nik0793/estacion-nativa/imagenes/dispositivos/mt3608-step-up.webp

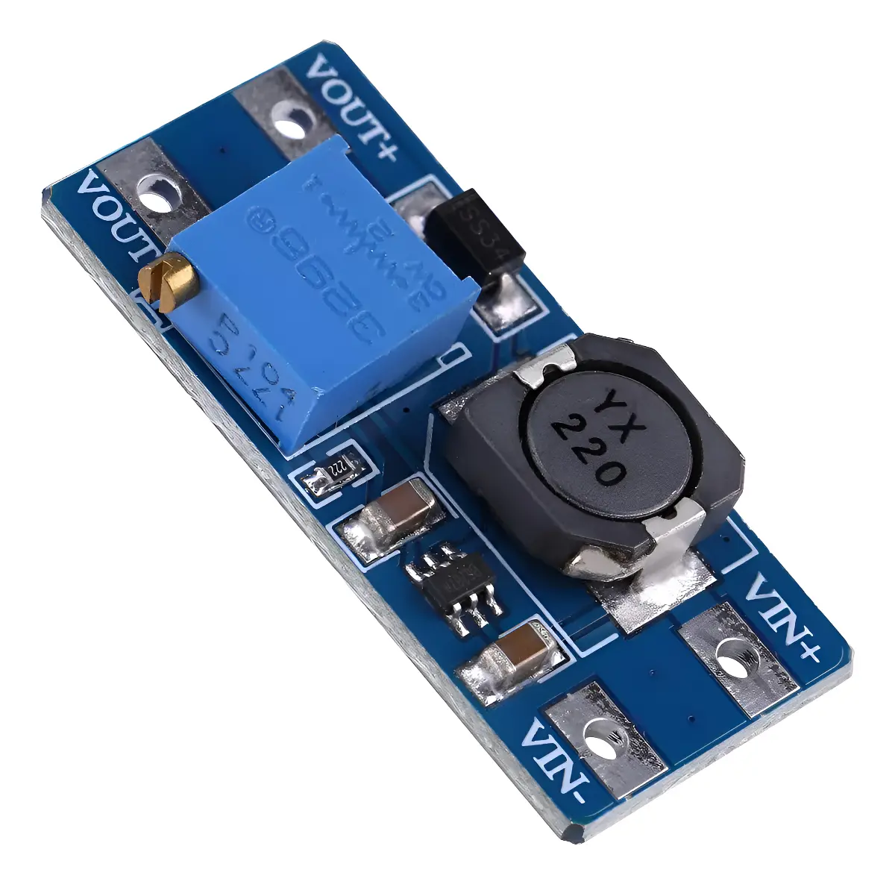
imagenes/dispositivos/mt3608-step-up.webp
