nik0793/estacion-nativa/imagenes/renders/05-maestra.png

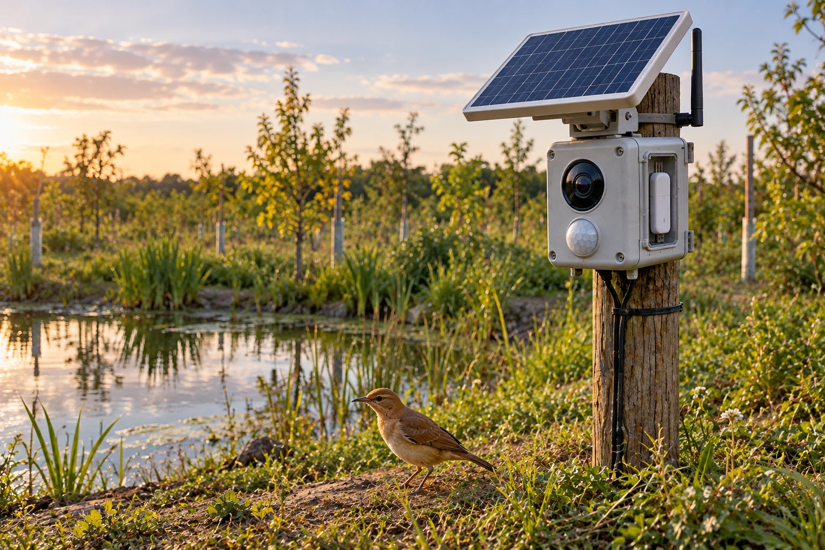
imagenes/renders/05-maestra.png
