nik0793/estacion-nativa/docs/informe-tecnico.html

Ecoestudio Solar · Proyecto de recuperación de aves nativas · Del Viso

# Estación Nativa Informe técnico para el taller · versión 1.0

Estación solar de agua y registro fotográfico de aves, con módem 4G compartido por sector. Lista de materiales con precios verificados, cálculo de energía, conexiones pin por pin, armado paso a paso, configuración del módem, especificación del firmware y del servidor.

Cómo usar este documento. Está escrito para ejecutarse en orden: primero la sección 7 (armado de una estación en la mesa) con la sección 6 (conexiones) al lado, después la 8 (módem), la 9 (firmware) y recién al final la 11 (campo). Cada paso termina en una verificación con el multímetro o con el monitor serie. Si una verificación falla, no seguir.

Preparado por Nicolás Gutiérrez · 11 de octubre de 2026 · Precios en pesos argentinos tomados de publicaciones de MercadoLibre el 11/10/2026 (ver links en la sección 3).

Carpeta del proyecto: D:\Documentos\estacion-aves · Repositorio público: github.com/nik0793/estacion-nativa · Fotos de los componentes en imagenes\dispositivos · Prompts para los renders en docs\prompts-imagenes.md

## 1. Qué vamos a construir

Un sector es un grupo de estaciones alrededor de un punto de interés (el estanque) a pocos metros entre sí. Todas comparten un solo módem 4G USB con WiFi y un solo chip. Cada estación es autónoma en energía: panel solar chico, dos pilas 18650 y un ESP32-CAM que duerme casi todo el tiempo.

- Estación base (la que se repite): ESP32-CAM + sensor PIR + panel + pilas. Saca dos fotos cuando un ave se posa, las guarda en su memoria flash y las sube en la próxima ventana de conexión.
- Estación maestra (una por sector): es una estación base que además enciende el módem 4G en ventanas horarias con una llave MOSFET y paneles y pilas extra.
- Estación comedero (una por sector): es una estación base que además mueve un servo dosificador de alimento en horarios programados y mide con una boya el nivel del tanque de agua.
- Agua: tanque de 20 litros por gravedad con válvula a flotante mecánica en el bebedero. No consume energía; el equipo solo avisa cuando el tanque está por vaciarse.

Figura 1. Arquitectura. Las estaciones no hablan entre sí: cada una se conecta al WiFi del módem en la ventana y habla con el servidor.

## 2. Decisiones de diseño (y por qué)

Decisión | Razón
El equipo duerme en deep sleep y el módem está apagado salvo en ventanas de 6 minutos por hora. | Un módem 4G encendido todo el día consume unas 10 veces más que todo el resto. Es lo único que permite usar paneles de 1,5 W y dos pilas.
Un módem por sector, compartido por WiFi. | Un solo chip y un solo equipo de 63.000 $ para 4 o más cámaras. Agregar una cámara cuesta solo la cámara.
Sin microSD: las fotos se guardan en la flash del ESP32 (LittleFS, 1,5 MB) hasta la ventana. | Libera 6 pines del ESP32-CAM (que es el cuello de botella), saca un componente que falla con humedad y ahorra energía. 1,5 MB guarda unas 30 fotos; sobra para una hora.
Agua por gravedad con flotante mecánico. | Cero energía, cero bombas, cero firmware. Es la parte que más usan las aves y la que menos puede fallar.
Una sola fuente de 5 V (módulo TP4056 + MT3608 integrados) alimenta al ESP32-CAM por su pin 5V. | Un módulo de 4.390 $ hace carga solar, protección de la pila y 5 V. Cuesta unos 6 mA extra en sueño; se acepta en v1 y se mejora en v2 (sección 13).
El PIR se alimenta directo de la pila (3,7 a 4,2 V), no de los 5 V. | El regulador del HC-SR501 funciona desde 3,6 V. Así el PIR sigue vivo con el ESP32 dormido y gasta 50 µA.
Identificación de especie en el servidor, no en el equipo. | BirdNET necesita una Raspberry Pi, que consume más en una hora que la estación en un día.
Los pájaros no se ven en vivo. Las órdenes (dar comida, sacar foto, cambiar horario) se ejecutan en la próxima ventana. | Consecuencia directa de dormir el módem. Hasta una hora de demora es aceptable para este uso.

## 3. Lista de materiales con precios verificados

Precios tomados el 11/10/2026 de las publicaciones indicadas. Los marcados (est.) son estimaciones de ferretería o insumos que ya tenés. Las fotos están en imagenes\dispositivos.

### 3.1 Estación base (se repite en cada punto)

Foto | Componente | Cant. | Unitario $ | Subtotal $ | Vendedor / publicación
 | ESP32-CAM con cámara OV2640 (AI-Thinker). Cerebro, WiFi y cámara en una placa de 27×40 mm. | 1 | 24.559 | 24.559 | Starware (Full) · MLA-784007609 (https://articulo.mercadolibre.com.ar/MLA-784007609-esp32-cam-camara-modulo-wifi-bt-arduino-ov2640-2mp-_JM)
 | Módulo J5019: cargador TP4056 + elevador MT3608, entrada USB-C y pads IN+/IN-, salida regulable 4,3 a 27 V, 1 A, con protección de la pila. | 1 | 4.390 | 4.390 | Informática San Isidro · MLA-1981186488 (https://articulo.mercadolibre.com.ar/MLA-1981186488-cargador-bateria-litio-tp4056-1a-con-fuente-boost-step-up-2a-_JM)
 | Panel solar 6 V 1,5 W epoxi, 112×91 mm, 250 mA. Van dos en paralelo. | 2 | 14.999 | 29.998 | Candy-Ho · MLA-637068205 (https://articulo.mercadolibre.com.ar/MLA-637068205-panel-solar-policristalino-mini-epoxy-6v-0-250ma-112x91-mm-_JM)
 | Pila 18650 3,7 V 3000 mAh. Van dos en paralelo. Hay celdas de 8.000 a 12.000 $ y recuperadas de notebook gratis; verificar capacidad real antes de usarlas. | 2 | 26.114 | 52.228 | Fullenergy · MLA-833373093 (https://articulo.mercadolibre.com.ar/MLA-833373093-bateria-recargable-de-litio-18650-37v-3000mah-_JM)
| Portapilas doble 18650 con cables. | 1 | 3.000 | 3.000 | (est.)
 | Sensor PIR HC-SR501. Despierta al ESP32 cuando algo se mueve frente al bebedero. | 1 | 3.229 | 3.229 | TodoMicro · MLA-878891033 (https://articulo.mercadolibre.com.ar/MLA-878891033-modulo-sensor-movimiento-pir-infrarrojo-hc-sr501-arduino-_JM)
| Dos resistencias de 100 kΩ, cable fino, conectores Dupont o JST, termocontraíble, un capacitor electrolítico de 470 µF 10 V. | 1 | 4.000 | 4.000 | (est.)
| Caja impresa en PETG o ASA, prensacable, tornillos, abrazaderas y poste de madera de 1 m. | 1 | 10.000 | 10.000 | (est.)
| Subtotal estación base | | | 131.404

### 3.2 Extras de la estación maestra (una por sector)

Foto | Componente | Cant. | Unitario $ | Subtotal $ | Vendedor / publicación
 | Módem 4G USB con WiFi, liberado. Bandas LTE B1/B2/B3/B4/B5/B7/B8/B17/B20/B28 (incluye B4 y B28, las de Argentina), hasta 10 equipos por WiFi, WPA2. Garantía del vendedor 1 mes, devolución ML 30 días. | 1 | 63.000 | 63.000 | Techno Space 044 (Full) · MLAU3374858134 (https://www.mercadolibre.com.ar/modem-4g-usb-wifi-liberado-inalambrico-lte/up/MLAU3374858134)
 | Elevador MT3608 2 A dedicado al módem, ajustado a 5,0 V. | 1 | 4.219 | 4.219 | Informática San Isidro · MLA-768204545 (https://articulo.mercadolibre.com.ar/MLA-768204545-fuente-convertidor-boost-elevador-dc-dc-step-up-2a-mt3608-_JM)
 | MOSFET AOD4184 (canal N, nivel lógico, TO-252). Llave que corta la alimentación del módem. Se suelda sobre un trozo de plaqueta perforada o adaptador. | 1 | 6.087 | 6.087 | ITT · MLA-640228615 (https://articulo.mercadolibre.com.ar/MLA-640228615-mosfet-n-aod4184a-40v-50a-to252-aod4184-_JM)
 | Dos paneles 6 V 1,5 W más (la maestra lleva cuatro). | 2 | 14.999 | 29.998 | Candy-Ho · MLA-637068205
 | Dos pilas 18650 más (la maestra lleva cuatro) y un portapilas doble extra. | 2 | 26.114 | 55.228 | Fullenergy · MLA-833373093 (+3.000 est. portapilas)
| Conector USB-A hembra para alimentar el módem, 100 Ω y 100 kΩ para el gate. | 1 | 1.500 | 1.500 | (est.)
| Subtotal extras maestra | | | 160.032

### 3.3 Extras de la estación comedero (una por sector)

Foto | Componente | Cant. | Unitario $ | Subtotal $ | Vendedor / publicación
 | Servo SG90 para la compuerta de la tolva de alimento. | 1 | 5.998 | 5.998 | Marstech · MLA79821906 (https://www.mercadolibre.com.ar/servo-motor-tower-pro-sg90-9g-compatible-arduino-rotacion/p/MLA79821906)
 | Segundo AOD4184 para cortar la alimentación del servo cuando no se usa. | 1 | 6.087 | 6.087 | ITT · MLA-640228615
 | Sensor de nivel a boya (interruptor flotante) para el tanque de agua. | 1 | 14.520 | 14.520 | ITT · MLA-830475459 (https://articulo.mercadolibre.com.ar/MLA-830475459-sensor-nivel-liquido-electrico-boya-flotante-itytarg-_JM)
| Bidón de 20 L, válvula flotante mecánica de 1/2" (tipo tanque de inodoro o bebedero de animales), manguera y bebedero de piedra o cemento. | 1 | 15.000 | 15.000 | (est., ferretería)
| Tolva impresa con compuerta para el servo. | 1 | 3.000 | 3.000 | (est., filamento)
| Subtotal extras comedero | | | 44.605

### 3.4 Comunes a todo el proyecto

Foto | Componente | Cant. | Unitario $ | Subtotal $ | Vendedor / publicación
 | Placa programadora ESP32-CAM-MB (CH340). Una sola para programar todas las estaciones. | 1 | 8.999 | 8.999 | HobbyTronica · MLA-1138363194 (https://articulo.mercadolibre.com.ar/MLA-1138363194-placa-base-programador-esp32-cam-ov2640-esp32-cam-mb-hobb-_JM)
| Chip prepago de la operadora con mejor señal en el predio + primer pack de 1 GB. | 1 | 5.000 | 5.000 | (est.) · costo mensual después: 3.000 a 5.000 $

## 4. Presupuesto del sector estanque (4 estaciones)

Ítem | Cant. | $
Estación base completa (incluye la de la maestra y la del comedero) | 4 | 525.616
Extras de la maestra (módem, llave, paneles y pilas extra) | 1 | 160.032
Extras del comedero (servo, boya, tanque, tolva) | 1 | 44.605
Programador y chip con primer mes | 1 | 13.999
Total del sector, todo nuevo | | 744.252
Costo mensual (datos del chip) | | 3.000 a 5.000

Dónde se puede bajar. Las pilas son el 29 % del total (8 celdas a 26.114 $). Con celdas recuperadas de packs de notebook, el sector baja a unos 535.000 $; con celdas nuevas de 10.000 $, a unos 615.000 $. La segunda partida grande son los 10 paneles de 1,5 W (150.000 $): para la maestra conviene cotizar un panel de 6 V 5 W o 6 W único, que suele salir menos que cuatro chicos.

Referencia: la alternativa con una placa integrada Waveshare ESP32-S3-SIM7670G cuesta 180.000 $ por estación más un chip por estación. Cuatro habrían salido 720.000 $ solo en placas.

### Para empezar: compra mínima de la etapa 1 (una estación en la mesa)

ESP32-CAM, programador, módulo J5019, dos paneles, dos pilas, portapilas, PIR y menudencias: unos 131.000 $ más el programador (9.000 $). Con eso se prueba todo el firmware usando el WiFi de tu casa como si fuera el módem. El módem se compra recién cuando la estación ya sube fotos.

## 5. Energía: por qué alcanza con paneles de 1,5 W

### 5.1 Consumo diario estimado

Carga | Cálculo | mAh/día
ESP32-CAM en deep sleep alimentado por el pin 5V (regulador AMS1117 + cámara) más pérdidas del elevador | 9 mA × 24 h | 216
PIR HC-SR501 desde la pila | 0,05 mA × 24 h | 1
Divisor de medición de batería (100 k + 100 k) | 0,02 mA × 24 h | 1
Eventos: despertar, encender cámara, 2 fotos, guardar | 40 eventos × 8 s × 250 mA | 22
Ventanas de subida: WiFi, NTP, subir ~10 fotos, bajar órdenes | 14 ventanas × 60 s × 200 mA | 47
Estación base | ≈ 1,1 Wh/día a 3,7 V | ≈ 290
Extra maestra: módem 4G encendido en las ventanas | 14 ventanas × 6 min × 1,2 W ≈ 1,7 Wh | ≈ 460
Estación maestra | ≈ 2,8 Wh/día | ≈ 750
Extra comedero: servo 2 veces por día, 5 s | despreciable | 1

### 5.2 Generación y autonomía

- Un panel epoxi de 1,5 W rinde al sol real cerca de 1 W. En Buenos Aires en invierno hay unas 2,5 horas equivalentes de sol pleno sobre un panel inclinado al norte. Con 85 % de rendimiento de carga: unos 2,1 Wh por panel por día en invierno, el doble en verano.
- Estación base: 2 paneles ≈ 4,2 Wh/día contra 1,1 Wh de consumo. Cubre cuatro días nublados seguidos sin tocar la reserva.
- Maestra: 4 paneles ≈ 8,5 Wh/día contra 2,8 Wh.
- Reserva: base 2 × 3000 mAh = 6000 mAh → 20 días sin sol. Maestra 4 × 3000 mAh → 16 días sin sol.

Verificación obligatoria en el paso 7.9: con el equipo dormido, el multímetro en serie con la pila tiene que marcar entre 7 y 11 mA en la estación base. Si marca más de 15 mA, algo quedó encendido (cámara sin apagar, LED de flash, módulo PIR mal alimentado) y hay que corregirlo antes de instalar.

Figura 2. Ciclo diario. Las estaciones despiertan a los 60 s de cada hora y buscan el WiFi del módem durante 2 minutos como máximo.

## 6. Conexiones pin por pin

### 6.1 Pines del ESP32-CAM que se usan

Pin ESP32-CAM | Función en la estación | Detalle
5V | Alimentación | Desde OUT+ del módulo J5019 ajustado a 5,0 V. Capacitor de 470 µF entre 5V y GND, lo más cerca posible de la placa.
GND | Masa común | Todas las masas unidas: J5019 OUT-, BAT-, PIR GND, divisor, MOSFET source.
GPIO13 | PIR OUT | Entrada de despertar (ext0, flanco alto). Es pin RTC, por eso funciona en deep sleep.
GPIO15 | Medición de batería | Punto medio del divisor 100 k / 100 k entre BAT+ y GND. Se lee por ADC2 antes de encender WiFi.
GPIO4 | Llave del módem (solo maestra) | Gate del AOD4184 a través de 100 Ω, con 100 kΩ de gate a GND. Es el mismo pin del LED de flash: el LED prende mientras el módem está encendido y sirve de indicador. En las estaciones base queda libre.
GPIO12 | Señal del servo (solo comedero) | Cable naranja del SG90. Nada más conectado a este pin: es pin de arranque y debe quedar en bajo al encender.
GPIO2 | Llave del servo (solo comedero) | Gate del segundo AOD4184 (100 Ω + 100 kΩ a GND) que corta la masa del servo.
GPIO14 | Boya del tanque (solo comedero) | Un cable de la boya a GPIO14, el otro a GND. Se lee con pull-up interno.
U0T / U0R / GPIO0 | Programación | Solo con la placa ESP32-CAM-MB. No conectar nada más ahí.
GPIO16, GPIO1, GPIO3 | No usar | PSRAM y UART.

### 6.2 Esquema de bloques

Figura 3. Bloques de conexión. "Drain", "Source" y "Gate" son las tres patas del AOD4184: con la impresión hacia arriba y las patas hacia abajo, Gate es la izquierda, Drain la del medio (y la lengüeta metálica), Source la derecha.

### 6.3 Reglas de cableado

- Cable de 0,5 mm² como mínimo entre pilas, J5019 y ESP32-CAM; los picos de WiFi son de 400 mA y el módem pide hasta 1,5 A del lado de la pila.
- Las dos pilas en paralelo tienen que ser del mismo modelo y estar a la misma tensión (±0,05 V) antes de unirlas. Medir cada una por separado.
- Las dos entradas de panel en paralelo van directo a IN+ e IN− del J5019. No conectar nunca el panel al pin 5V del ESP32.
- Ajustar el trimmer del elevador a 5,0 V antes de conectar el ESP32-CAM, midiendo OUT+ con el multímetro y una carga chica (una resistencia de 1 kΩ).
- En el HC-SR501: jumper en posición L (un solo disparo), trimmer de tiempo al mínimo (todo a la izquierda, unos 3 s), trimmer de sensibilidad a la mitad.

## 7. Armado de una estación base, paso a paso

Tiempo estimado: una tarde para la primera, dos horas para las siguientes. Herramientas: soldador, multímetro, pelacables, PC con Arduino IDE 2.x, cable micro USB de datos.

1. Probar el ESP32-CAM pelado. Montarlo sobre la placa ESP32-CAM-MB, conectar por USB. En Arduino IDE instalar el paquete "esp32 by Espressif" (versión 3.x), elegir placa AI Thinker ESP32-CAM, Partition Scheme: Huge APP (3MB No OTA/1MB SPIFFS), velocidad 115200. Abrir Ejemplos → ESP32 → Camera → CameraWebServer, poner el WiFi de tu casa, subir. Verificación: en el monitor serie aparece una IP; al abrirla en el navegador se ve video. Si la imagen tiene franjas o está verde, reasentar el cable plano de la cámara.
2. Enfocar la lente a 60 cm. Con el video en pantalla y un objeto con texto a 60 cm, girar el aro de la lente (viene pegado; se despega con cuidado con una pinza) hasta que el texto esté nítido. Fijar con una gota de esmalte. Esa es la distancia a la que va a estar la percha o el borde del bebedero.
3. Preparar las pilas. Medir cada 18650: tienen que estar entre 3,6 y 4,1 V y con menos de 0,05 V de diferencia entre sí. Si no, cargarlas por separado en un cargador de 18650 antes de ponerlas juntas en el portapilas.
4. Módulo J5019. Soldar el portapilas a BAT+ y BAT− (respetar polaridad; el módulo no tiene protección contra inversión). Soldar dos cables a IN+ e IN− para los paneles. Poner las pilas. Con el multímetro en OUT+ / OUT− y una resistencia de 1 kΩ como carga, girar el trimmer hasta leer 5,00 V. Verificación: 5,0 V estables; el LED de carga del TP4056 prende al conectar un panel al sol o un USB-C.
5. Alimentar el ESP32-CAM. Soldar OUT+ al pin 5V y OUT− a GND del ESP32-CAM, con el capacitor de 470 µF entre ambos. Verificación: el ESP32 arranca (LED rojo trasero parpadea al reset) y el CameraWebServer sigue funcionando sin la placa MB conectada por USB.
6. PIR. VCC del HC-SR501 a BAT+ (no a los 5 V), GND a GND, OUT a GPIO13. Jumper en L, tiempo al mínimo, sensibilidad a la mitad. Verificación: con un sketch mínimo que imprima digitalRead(13) cada 200 ms, al pasar la mano a 1 m la salida va a 1 durante unos 3 s y vuelve a 0. Esperar 60 s después de encender: el PIR se calibra.
7. Divisor de batería. 100 kΩ de BAT+ a GPIO15 y 100 kΩ de GPIO15 a GND. Verificación: analogReadMilliVolts(15) × 2 tiene que coincidir con la tensión de la pila medida con el multímetro, ±0,1 V.
8. Cargar el firmware de la estación (sección 9) con el WiFi de tu casa en la configuración y el servidor de pruebas. Verificación: al mover la mano frente al PIR, en 10 s aparece una foto nueva en el servidor (o en el monitor serie se lee "foto guardada", y en la próxima ventana "subida OK").
9. Medir el consumo en sueño. Multímetro en escala de mA en serie con el cable BAT+ del portapilas. Con el equipo dormido (más de 30 s sin movimiento): 7 a 11 mA. Si da más de 15 mA, revisar que el firmware apague la cámara (esp_camera_deinit()) y el LED de flash antes de dormir.
10. Paneles. Soldar los dos paneles en paralelo (+ con +, − con −) y a IN+ / IN− del J5019 con cable de al menos 2 m hasta la caja. Verificación: al sol, con las pilas a menos de 4,1 V, el LED rojo del TP4056 prende y la tensión de las pilas sube lentamente.
11. Caja. Imprimir la caja (sección 11), montar el ESP32-CAM con la lente en la ventana, el PIR con su cúpula asomando debajo de la lente, el J5019 y el portapilas abajo. Prensacable para los cables del panel. Silicona neutra en la ventana de la lente y en la cúpula del PIR. Sobre de gel de sílice adentro.

### 7.1 Extras de la maestra

1. Soldar el AOD4184 sobre un trozo de plaqueta perforada: Source a BAT−, Drain a IN− del MT3608 de 2 A, Gate a GPIO4 a través de 100 Ω y con 100 kΩ entre Gate y Source.
2. MT3608: IN+ a BAT+. Ajustar la salida a 5,0 V con carga de 1 kΩ antes de conectar el módem (poner GPIO4 en alto desde un sketch de prueba para que el MOSFET conduzca).
3. Conector USB-A hembra: pin 1 (VBUS) a OUT+, pin 4 (GND) a OUT−. Enchufar el módem. Verificación: con GPIO4 en alto, el módem enciende y a los 30–45 s aparece su red WiFi en el celular; con GPIO4 en bajo, el consumo de la rama del módem es 0.
4. La maestra lleva cuatro paneles (dos pares en paralelo) y dos portapilas (cuatro celdas en paralelo), todo al mismo J5019.

### 7.2 Extras del comedero

1. Segundo AOD4184: Source a GND, Drain al cable marrón del servo, Gate a GPIO2 con 100 Ω y 100 kΩ a GND. Rojo del servo a OUT+ (5 V), naranja a GPIO12.
2. Boya: un cable a GPIO14, el otro a GND. Montarla en el bidón a la altura que corresponda a "quedan 3 litros".
3. Verificación: con la orden "dar comida ahora" desde el servidor, en la próxima ventana el servo abre la compuerta 1 s y cierra; con el bidón vacío el estado reporta tanque: bajo.

## 8. Módem 4G y chip

1. Antes de comprar el chip: ir al estanque con un celular de cada operadora (Claro, Personal, Movistar) y anotar las barras de 4G en el lugar exacto de la maestra, a 1,5 m del suelo. Se compra el chip de la que tenga mejor señal. Si ninguna tiene 4G ahí, probar en el punto más alto del predio: la maestra puede ir hasta 15 m de las otras estaciones.
2. Chip prepago a nombre de Iván, con pack de datos de 1 GB mensual y recarga automática desde la app de la operadora. Consumo esperado: 150 a 250 MB por mes para cuatro estaciones.
3. Primera configuración del módem, en la casa, enchufado a un cargador USB: poner el chip, esperar 1 minuto, conectarse desde el celular al WiFi del módem (nombre y clave impresos en la etiqueta), entrar al panel del módem desde el navegador (la etiqueta indica la dirección; suele ser 192.168.0.1 o 192.168.100.1).
4. En el panel: cambiar el nombre de la red WiFi a estacion-nativa y la clave a una de 12 caracteres (anotarla en el firmware). Si pide APN, usar el de la operadora: Claro internet.ctimovil.com.ar, Personal datos.personal.com, Movistar internet.gprs.unifon.com.ar. Desactivar cualquier opción de "apagado automático del WiFi" o "ahorro de energía" si existe.
5. Verificación: el celular navega por el WiFi del módem. Desenchufar y volver a enchufar: el módem tiene que reconectarse solo, sin tocar nada, en menos de 60 s. Si no lo hace, devolverlo (hay 30 días).
6. Bandas: la publicación declara B1/B2/B3/B4/B5/B7/B8/B17/B20/B28. Las de Argentina son B4, B7 y B28, así que está cubierto. Igual, probar en el campo dentro de los 30 días de devolución.

Alternativa si el módem genérico falla: Huawei E8372 usado de Personal (13.500 a 22.000 $ en ML). La versión que vendió Personal en Argentina (E8372h-608) trae B4 y B28. Debe comprarse "liberado". Se conecta exactamente igual.

## 9. Firmware de la estación

Un solo sketch para los tres tipos de estación; el tipo se elige con una constante. Carpeta: firmware\estacion\estacion.ino. Librerías: solo las que vienen con el paquete esp32 (esp_camera, WiFi, HTTPClient, LittleFS, esp_sleep).

### 9.1 Comportamiento

1. Arranque. Lee la causa del despertar: PIR (ext0), temporizador (ventana) o encendido. Lee la tensión de la pila por GPIO15 antes de encender WiFi.
2. Si despertó por PIR y es de día (6 a 20 h): inicia la cámara en SVGA 800×600, JPEG calidad 12, descarta 2 cuadros, guarda una foto, espera 1,5 s, guarda otra. Nombre: /f_ESTACION_AAAAMMDD_HHMMSS_n.jpg. Si LittleFS supera 1,4 MB, borra la foto más vieja. Apaga la cámara. Si la pila está por debajo de 3,5 V, no saca fotos (solo reporta estado en la ventana).
3. Si es hora de ventana (minuto 1 de cada hora de 7 a 20, y a las 0 h): en la maestra, primero pone GPIO4 en alto y espera 45 s. Todas: conectan al WiFi estacion-nativa con 90 s de tope; si no aparece, duermen hasta la próxima. Con WiFi: sincroniza hora por NTP, sube cada foto pendiente con POST multipart a /api/foto.php (borra el archivo al recibir 200), envía el estado a /api/estado.php (pila, fotos pendientes, tanque, causa de despertar), pide órdenes a /api/ordenes.php?estacion=ID y las ejecuta (dar comida: GPIO2 alto, servo a 90° un segundo, a 0°, GPIO2 bajo; foto ahora; cambiar horarios). La maestra apaga el módem al terminar o a los 6 minutos.
4. Comedero: en las ventanas de las 8 y las 17 h ejecuta la dosificación programada aunque no haya órdenes.
5. Dormir. Calcula los segundos hasta la próxima ventana, programa el temporizador y, si es de día, habilita ext0 en GPIO13. esp_deep_sleep_start().

### 9.2 Constantes que se editan por estación

#define ID_ESTACION      "estanque-1"     // estanque-1 (maestra), estanque-2, comedero-1
#define TIPO_ESTACION    BASE             // BASE, MAESTRA o COMEDERO
#define WIFI_SSID        "estacion-nativa"
#define WIFI_CLAVE       "..."            // la que se puso en el módem
#define SERVIDOR         "https://skyblue-gorilla-834934.hostingersite.com"  // sitio de Hostinger, sin barra final
#define CLAVE_API        "..."            // 24 caracteres, igual en el servidor
#define HORA_INICIO_PIR  6
#define HORA_FIN_PIR     20
#define MINUTO_VENTANA   1                // la maestra enciende el módem en el minuto 0
#define PILA_MINIMA_MV   3500

### 9.3 Cómo cargarlo

1. Montar el ESP32-CAM en la placa MB, conectar el USB. Si la placa está armada en la caja, desconectar antes OUT+ del J5019 (el USB ya alimenta).
2. Arduino IDE: placa AI Thinker ESP32-CAM, Huge APP, 115200. Editar las constantes. Mantener apretado el botón IO0 de la MB mientras se presiona RST una vez si el IDE no entra en modo carga solo.
3. Abrir el monitor serie a 115200 y presionar RST. Verificación: se lee la causa de despertar, la tensión de pila y "durmiendo hasta HH:MM".

El sketch completo está en firmware\estacion\estacion.ino y compila con el núcleo esp32 3.3.11 (1,2 MB, partición Huge APP). Todavía no se probó en un ESP32-CAM real: el paso 8 de la sección 7 es esa prueba. Lo que está en esta sección es el contrato que el sketch cumple; si algo del comportamiento cambia, cambia acá primero. El servidor está en servidor\ (esquema SQL, API, galería y panel).

## 10. Servidor en Hostinger

PHP 8 con SQLite en el plan Premium de Hostinger que ya tenés: no hay que crear ninguna base de datos, el archivo se crea solo en domains\<sitio>\datos, fuera de la carpeta pública. Carpeta del código: servidor\. Se publica con desplegar.sh <dominio> por SSH junto con la web; las claves van en config.local.php en el servidor (copiar el .ejemplo). Publicado en https://skyblue-gorilla-834934.hostingersite.com/ (web en /, registros en /registros/, app en /app/); hay un espejo de la web en GitHub Pages.

Endpoint | Método | Qué hace
/api/foto.php | POST multipart | Campos: estacion, clave, tomada (fecha ISO), archivo (jpg). Guarda en /fotos/AAAA/MM/, inserta fila en fotos, responde 200 y {"ok":true}. Rechaza sin clave válida o archivos de más de 300 KB.
/api/estado.php | POST JSON | {estacion, clave, pila_mv, pendientes, tanque, causa, version}. Actualiza estaciones. Si pila_mv < 3600 o tanque = bajo, deja un aviso que la app muestra.
/api/ordenes.php | GET | ?estacion=ID&clave=.... Devuelve las órdenes pendientes y las marca como entregadas: [{"id":12,"tipo":"comida"},{"id":13,"tipo":"foto"},{"id":14,"tipo":"horario","valor":"8,17"}].
/api/contacto.php | POST | Formulario de contacto de la web: nombre, correo, mensaje. Guarda en contactos, se ve en la app y, si está configurado, avisa por mail.
/registros/ | GET | Registros públicos: últimas fotos, galería por día, especies de la semana (cuando exista BirdNET) y estado de las estaciones. La web del proyecto es /index.html.
/app/ | GET | PWA para Iván con clave: últimas fotos, pila y tanque de cada estación, botones "dar comida", "sacar foto", horarios.

### Tablas

estaciones (id, nombre, tipo, ultimo_contacto, pila_mv, pendientes, tanque, causa, version, arranques)
fotos      (id, estacion, tomada, recibida, archivo, bytes, especie, confianza, publicada)
ordenes    (id, estacion, tipo, valor, creada, entregada)
avisos     (id, estacion, texto, creado, visto)
contactos  (id, nombre, correo, mensaje, origen, creado, leido)

Las tablas se crean solas en la primera llamada (función asegurarEsquema en config.php). Copia de seguridad: bajar datos\estacion.sqlite y la carpeta fotos\.

Identificación de especies (v2): un script en tu PC o en la PiPO baja cada noche las fotos nuevas y los clips de audio (cuando las estaciones tengan micrófono), corre BirdNET-Analyzer sobre el audio y escribe especie y confianza por la API. Mientras tanto, Iván etiqueta a mano desde la app: cada foto tiene un botón "¿qué ave es?" con las 15 especies más probables de la zona.

## 11. Caja, montaje y puesta en campo

### 11.1 Caja impresa

- Cuerpo de 95 × 70 × 55 mm interior, paredes de 2,4 mm, PETG o ASA (el PLA se deforma al sol). Tapa con labio y junta de silicona o cordón de TPU. Cuatro tornillos M3 con insertos.
- Frente: ventana de 10 mm para la lente, con un visera de 15 mm arriba para la lluvia y el sol directo; agujero de 23 mm para la cúpula del PIR, 25 mm debajo de la lente.
- Abajo: prensacable PG7 para los cables del panel y, en el comedero, para el servo y la boya. Un agujero de 2 mm en el punto más bajo como respiradero y drenaje, cubierto por dentro con un trocito de tela.
- Atrás: dos ojales para abrazaderas al poste. La maestra lleva además una ventana para el módem o, más simple, el módem adentro de la caja con una caja un poco más larga (el módem mide 100 × 30 × 12 mm) y una pequeña ventana de plástico transparente para ver su LED.
- Paneles: sobre el poste, en una ménsula impresa o de chapa, inclinados 35° hacia el norte, por encima de la caja. Nunca debajo de una copa de árbol: los árboles que se plantan van a crecer.

### 11.2 Ubicación en el estanque

- Lente a 60 cm del lugar donde se posan: borde del bebedero o una percha (rama seca de 15 mm clavada a 30 cm del agua). La cámara a 40 cm de altura, apuntando levemente hacia abajo. El sol nunca de frente a la lente: cámaras mirando al sur o al este.
- PIR cubriendo el mismo punto. Evitar que vea el agua con el sol reflejado o ramas que se mueven con el viento; si dispara en falso, bajar la sensibilidad o tapar la mitad de la cúpula con cinta.
- La maestra en el punto más alto y despejado del sector, a no más de 15 m de la estación más lejana, con vista directa (sin paredes ni troncos gruesos en el medio).
- Bebedero de piedra o cemento, de 3 cm de profundidad máxima con bordes rugosos; tanque de 20 L a 50 cm de altura, conectado con manguera a la válvula flotante del bebedero. Limpiar el bebedero una vez por semana.
- Tolva de alimento a 1,5 m del agua, con alimento para nativas: semilla de girasol negro, mijo y fruta cortada para zorzales y calandrias. Dosificar poco (30 g por vez) para que no quede comida en el piso.

### 11.3 Día de instalación, lista de control

- Las cuatro estaciones subieron fotos desde la casa con el WiFi del módem antes de salir al campo.
- Todas las pilas por encima de 3,9 V.
- Hora del sistema correcta (se ve en el nombre de las fotos).
- Postes clavados 40 cm, caja a 40 cm del suelo, panel al norte a 35°.
- Celular conectado al WiFi del módem desde la posición de cada estación: señal de al menos 2 barras.
- Primera ventana completa observada en el servidor: las cuatro estaciones reportaron estado.
- Bebedero lleno, válvula flotante cortando, tanque lleno, boya reportando "ok".
- Foto de cada estación instalada, para el informe y la web.

## 12. Pruebas de aceptación

Prueba | Cómo | Resultado esperado
Disparo por ave | Pasar la mano a 60 cm de la lente | Dos fotos nítidas en el servidor en la próxima ventana, con la hora correcta
Consumo en sueño | Multímetro en serie con BAT+ | Base: 7 a 11 mA. Maestra con módem apagado: igual
Ventana | Mirar la maestra a la hora en punto | LED de flash prende a :00, red WiFi visible a :01, LED apaga antes de :07
Falta de WiFi | Apagar la maestra una hora | Las estaciones guardan las fotos y las suben en la ventana siguiente; nada se pierde
Orden | "Dar comida ahora" desde la app | En la próxima ventana el servo actúa y el estado lo confirma
Tanque bajo | Levantar la boya con la mano | Aviso en la app en la próxima ventana
Pila baja | Simular con el firmware (PILA_MINIMA_MV = 4300) | La estación deja de fotografiar y reporta "pila baja"; vuelve a fotografiar al bajar el umbral
Una semana sin intervención | Dejar el sector 7 días | Tensión de pilas estable o subiendo; fotos todos los días; ninguna estación muda

## 13. Mejoras previstas (versión 2)

Mejora | Qué cambia | Costo
XIAO ESP32S3 Sense en vez de ESP32-CAM | Suma micrófono (BirdNET por audio), 8 MB de PSRAM, mejor cámara OV5640 opcional y deep sleep de microamperios con la cámara apagada de verdad. Mismo resto de la estación. | 62.000 $ (MLA-1464391993 (https://articulo.mercadolibre.com.ar/MLA-1464391993-placa-de-desarrollo-seeed-studio-xiao-esp32-s3-sense-_JM)), +37.000 $ por estación
Regulador 3,3 V de baja caída (MCP1826 o similar) alimentando el pin 3V3 | Baja el sueño del ESP32-CAM de 9 mA a unos 2,5 mA. Permite una pila y un panel por estación. | Menos de 3.000 $
Comparación de cuadros antes de guardar | Descarta fotos donde no cambió nada (viento, insectos). Menos datos y menos trabajo de etiquetado. | Solo firmware
Placa única con XIAO + módulo A7670SA | Reemplaza módem USB y llave por un módem de placa para una estación sola, lejos de cualquier sector. | A7670SA 95.000 a 139.000 $; alternativa LilyGO T-SIM7670G 77.999 $ (MLA-1958232026 (https://articulo.mercadolibre.com.ar/MLA-1958232026-modulo-t-sim-sim7670g-4g-lte-cat1-_JM), sin cámara)
Identificación automática con BirdNET | Audio de 10 s por evento, analizado de noche en tu PC o en la PiPO; especie y confianza en la web. | Sin costo; licencia no comercial de BirdNET

## 14. Referencias

- Bandas LTE en Argentina (B4, B7, B28): kimovil.com/es/frequency-checker/AR
- BirdNET-Analyzer (Cornell Lab / Chemnitz): github.com/kahst/BirdNET-Analyzer · modelo CC BY-NC-SA 4.0
- Merlin Bird ID es gratuito pero no es software libre; se usa como referencia de especies, no como componente.
- ESP32-CAM: consumo en deep sleep de hasta 6 mA (ficha del vendedor y mediciones de la comunidad); pines RTC válidos para ext0: 0, 2, 4, 12, 13, 14, 15.
- Publicaciones de MercadoLibre citadas en la sección 3, consultadas el 11/10/2026.
