nik0793/estacion-nativa/imagenes/dispositivos/bateria-18650.webp

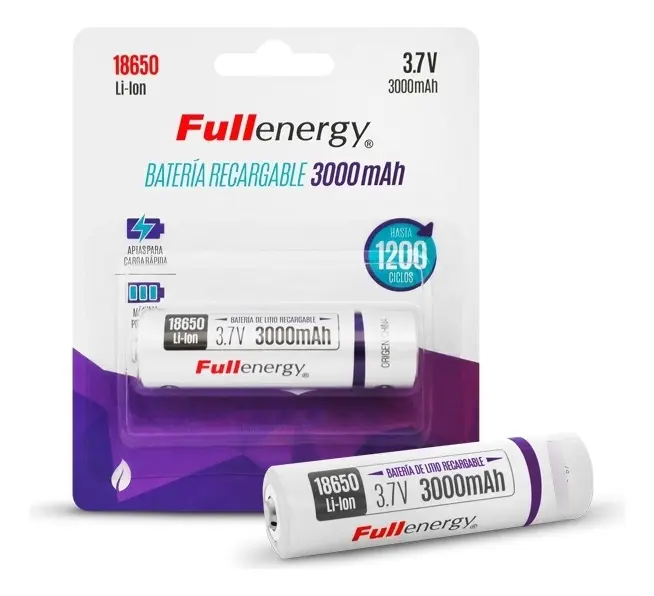
imagenes/dispositivos/bateria-18650.webp
