nik0793/estacion-nativa/imagenes/dispositivos/esp32-cam-mb.webp

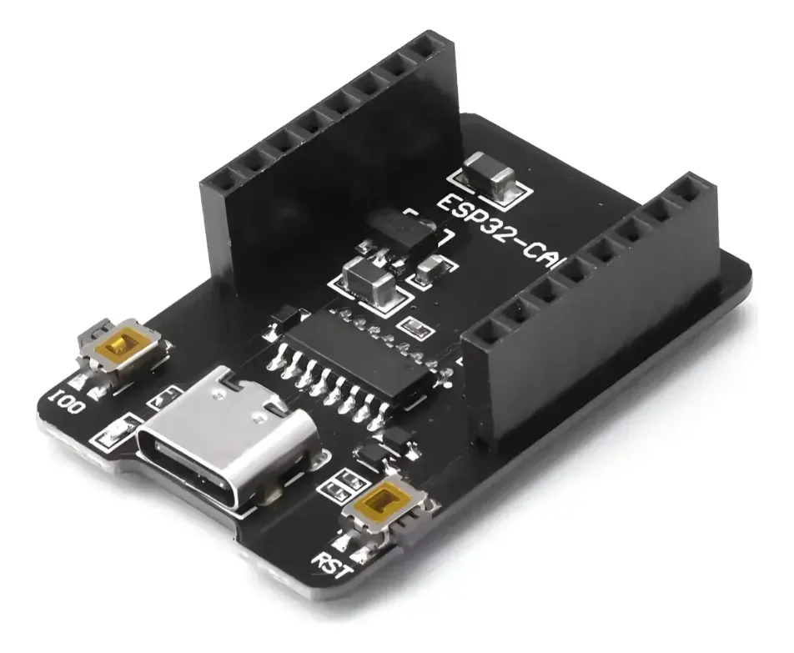
imagenes/dispositivos/esp32-cam-mb.webp
