nik0793/estacion-nativa/imagenes/dispositivos/esp32-cam.webp

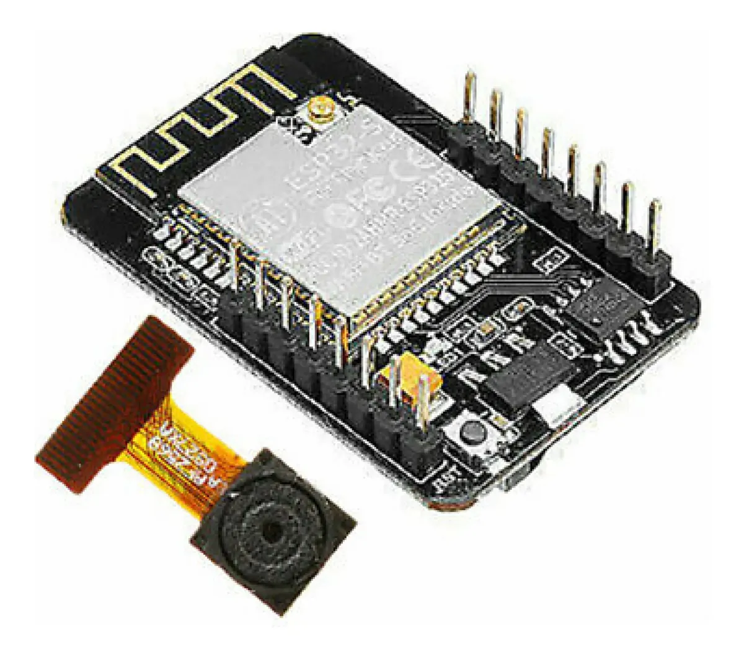
imagenes/dispositivos/esp32-cam.webp
