nik0793/estacion-nativa/imagenes/dispositivos/lilygo-t-sim7670g.webp

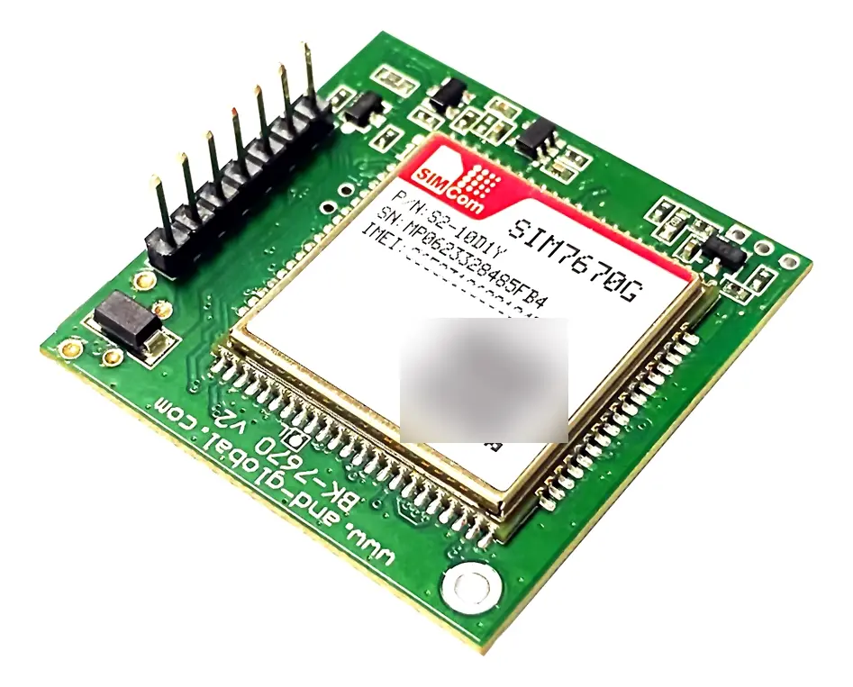
imagenes/dispositivos/lilygo-t-sim7670g.webp
