nik0793/estacion-nativa/imagenes/dispositivos/modem-4g-usb-wifi-3.webp

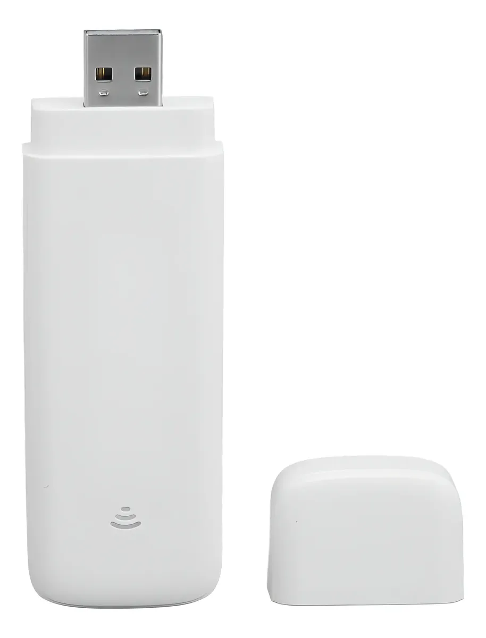
imagenes/dispositivos/modem-4g-usb-wifi-3.webp
