nik0793/estacion-nativa/imagenes/dispositivos/modem-4g-usb-wifi.webp

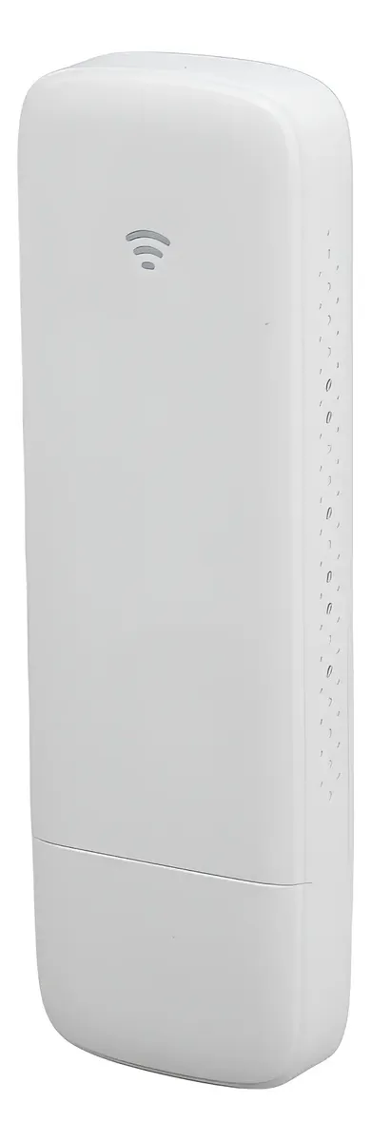
imagenes/dispositivos/modem-4g-usb-wifi.webp
