nik0793/estacion-nativa/imagenes/dispositivos/mosfet-aod4184.webp

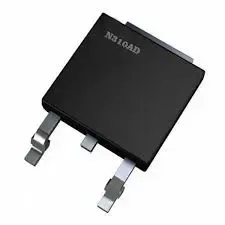
imagenes/dispositivos/mosfet-aod4184.webp
