nik0793/estacion-nativa/imagenes/dispositivos/mosfet-irf520.webp

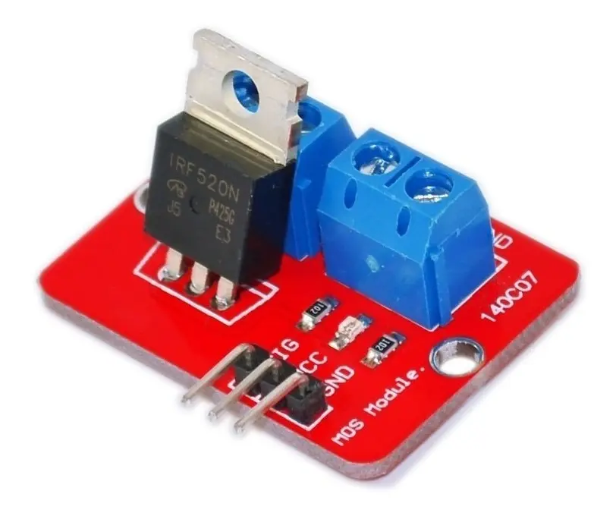
imagenes/dispositivos/mosfet-irf520.webp
