nik0793/estacion-nativa/imagenes/dispositivos/panel-solar-6v-1_5w.webp

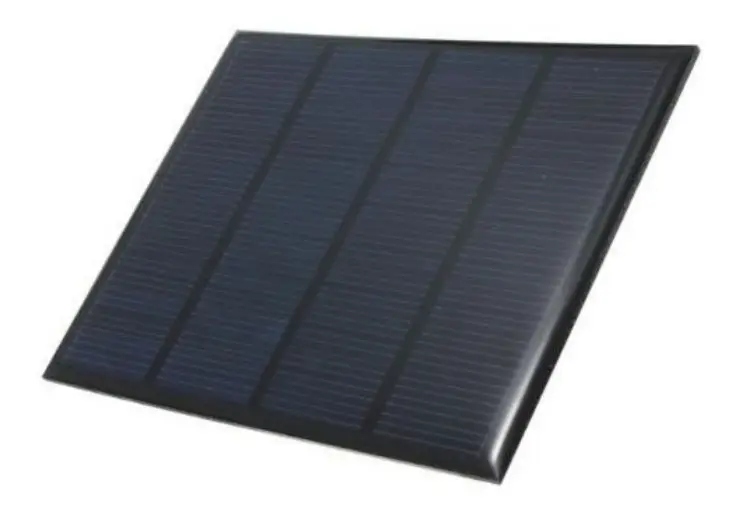
imagenes/dispositivos/panel-solar-6v-1_5w.webp
