nik0793/estacion-nativa/imagenes/dispositivos/pir-hc-sr501.webp

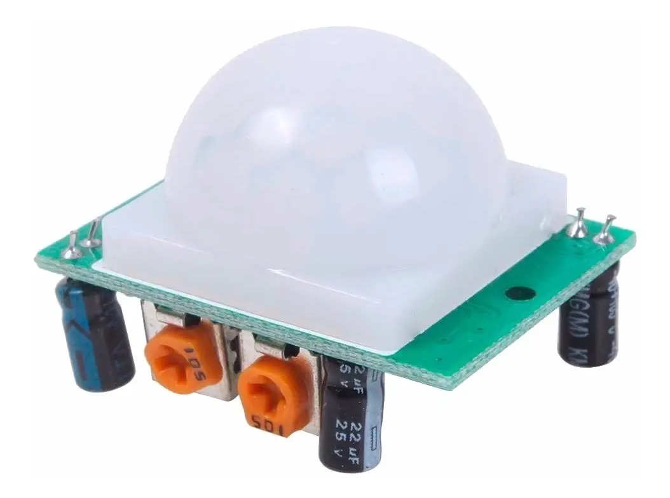
imagenes/dispositivos/pir-hc-sr501.webp
