nik0793/estacion-nativa/imagenes/dispositivos/sensor-boya-flotante.webp

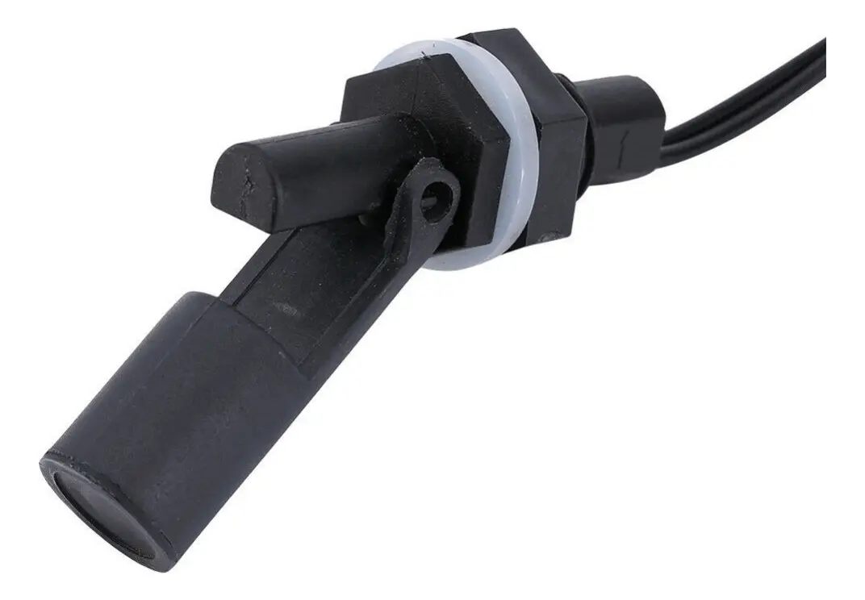
imagenes/dispositivos/sensor-boya-flotante.webp
