nik0793/estacion-nativa/imagenes/dispositivos/servo-sg90.webp

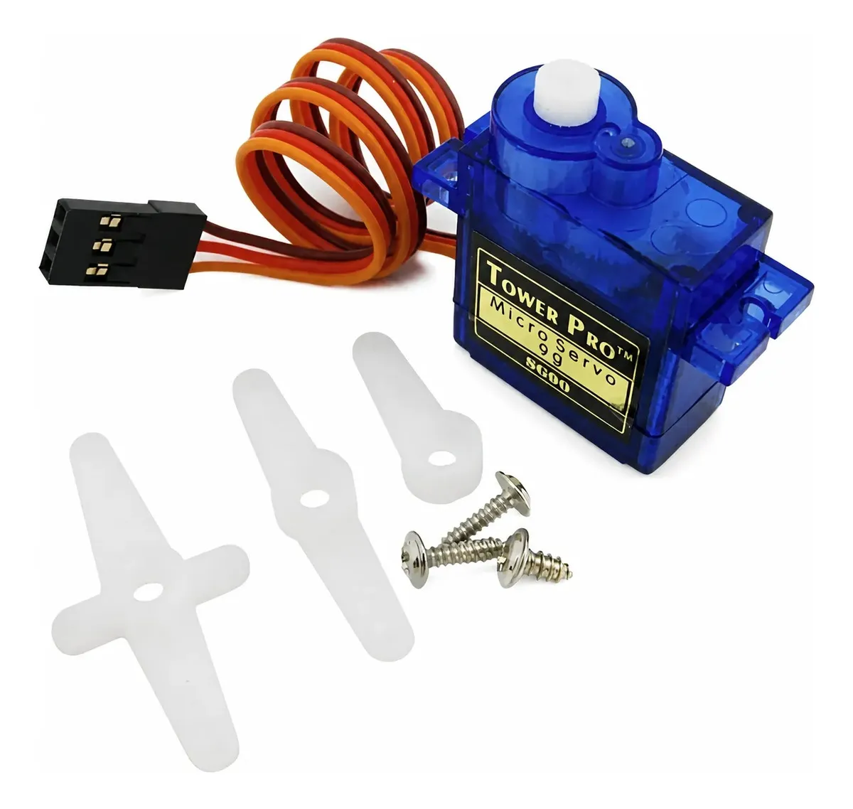
imagenes/dispositivos/servo-sg90.webp
