nik0793/estacion-nativa/imagenes/dispositivos/tp4056-boost-j5019.webp

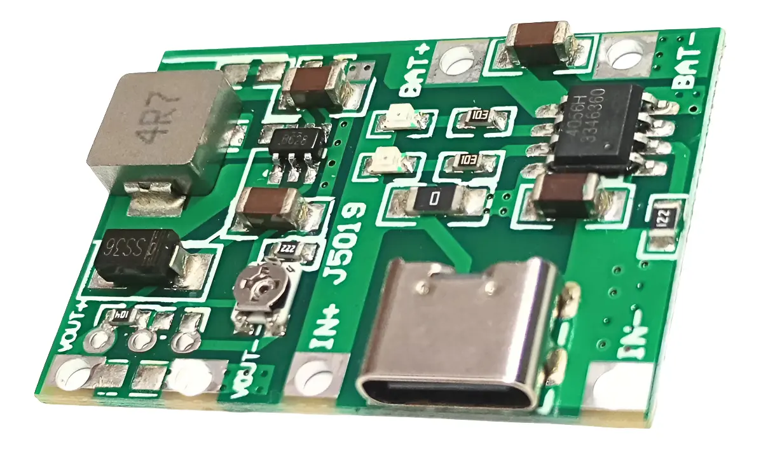
imagenes/dispositivos/tp4056-boost-j5019.webp
