nik0793/estacion-nativa/imagenes/dispositivos/tp4056-usbc.webp

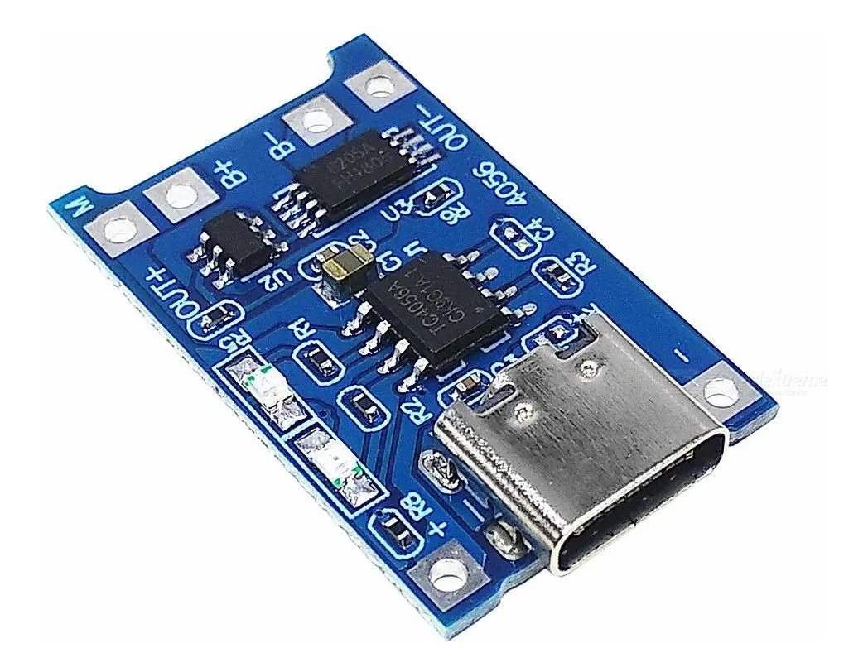
imagenes/dispositivos/tp4056-usbc.webp
