nik0793/estacion-nativa/imagenes/dispositivos/xiao-esp32s3-sense.webp

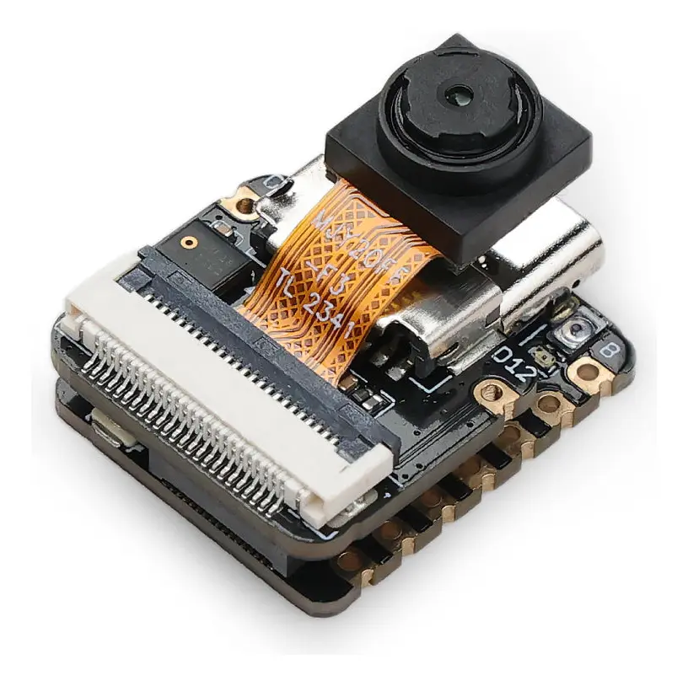
imagenes/dispositivos/xiao-esp32s3-sense.webp
