nik0793/estacion-nativa/imagenes/renders/01-hero.png

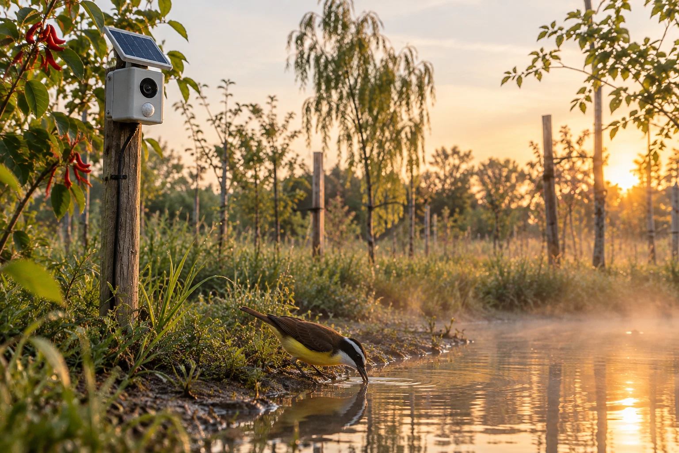
imagenes/renders/01-hero.png
