nik0793/estacion-nativa/imagenes/renders/02-estanque.png

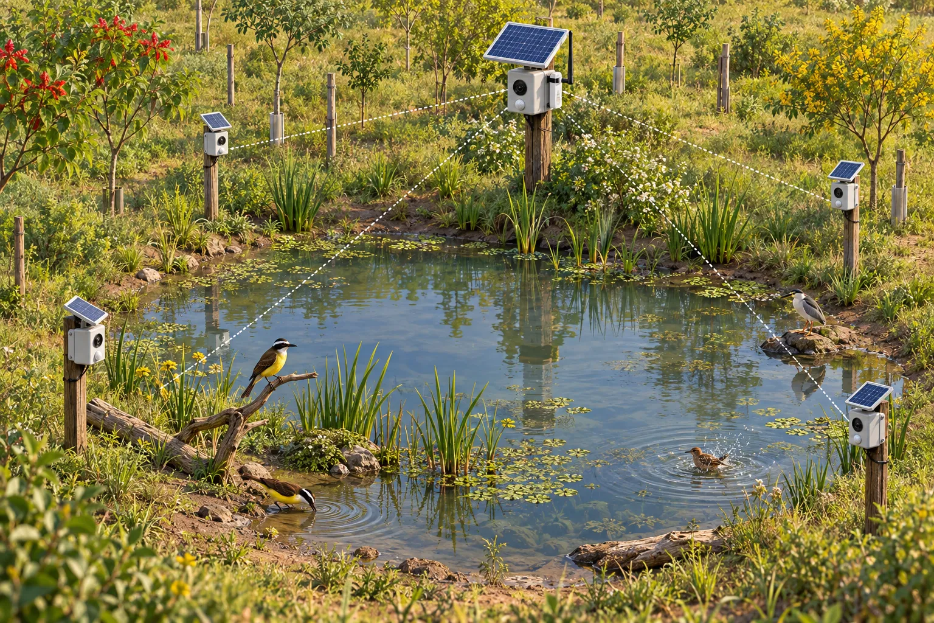
imagenes/renders/02-estanque.png
