nik0793/estacion-nativa/imagenes/renders/03-explotada.png

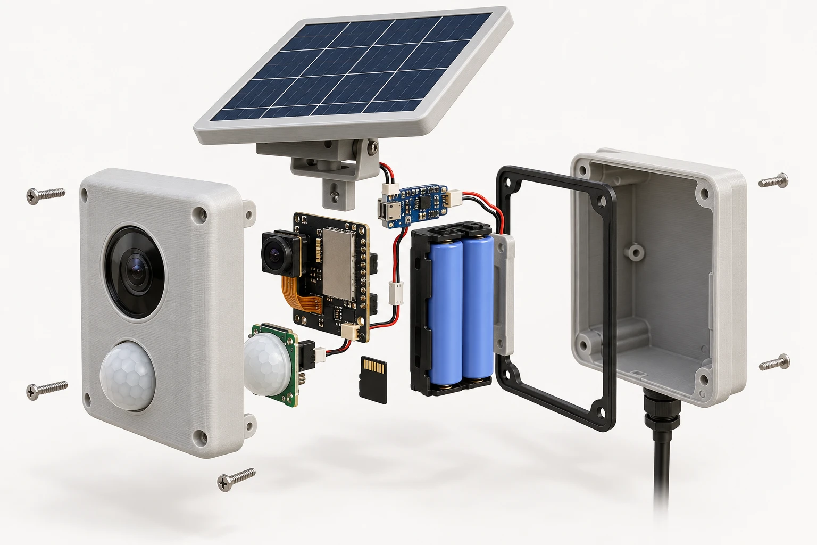
imagenes/renders/03-explotada.png
