nik0793/estacion-nativa/imagenes/renders/04-percha.png

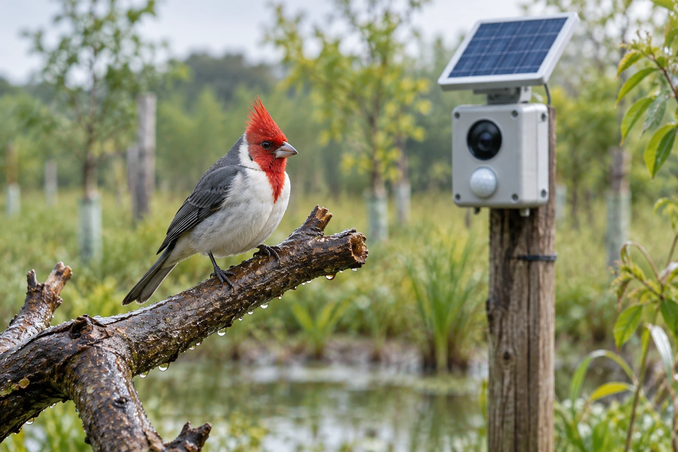
imagenes/renders/04-percha.png
