nik0793/estacion-nativa/imagenes/renders/09-arboles.png

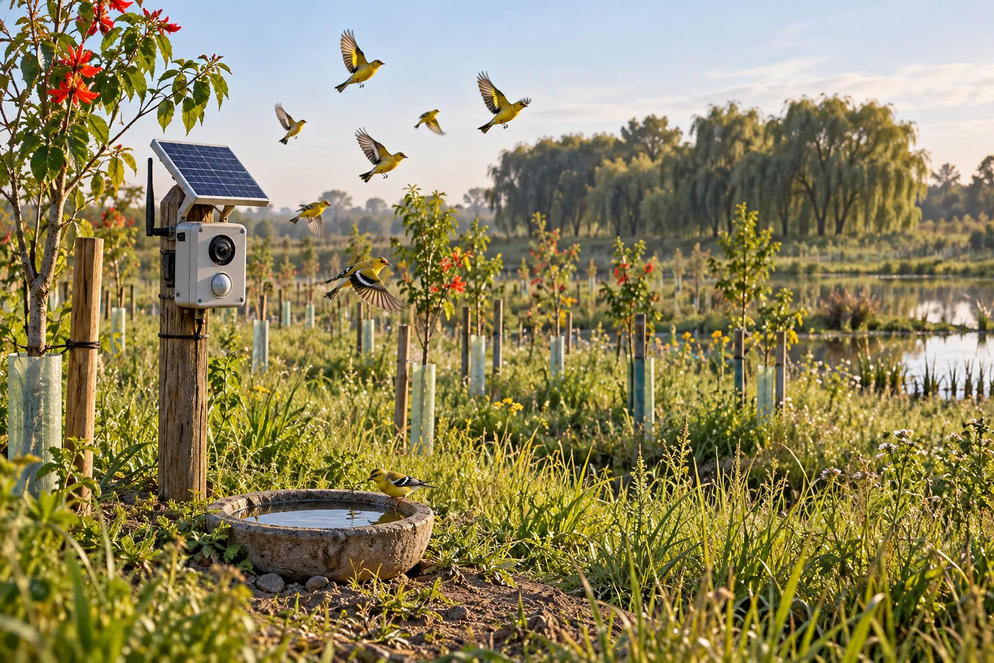
imagenes/renders/09-arboles.png
