nik0793/estacion-nativa/imagenes/renders/14-isotipo.png

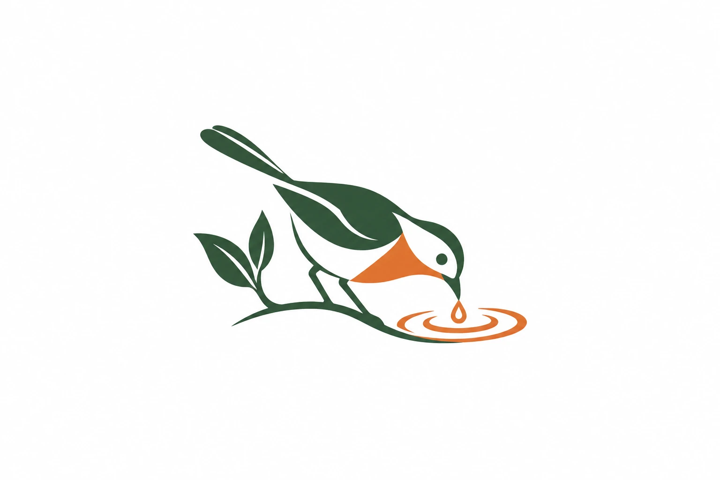
imagenes/renders/14-isotipo.png
