nik0793/estacion-nativa/imagenes/renders/_08-web-revisar-dice-vida-silvestre.png

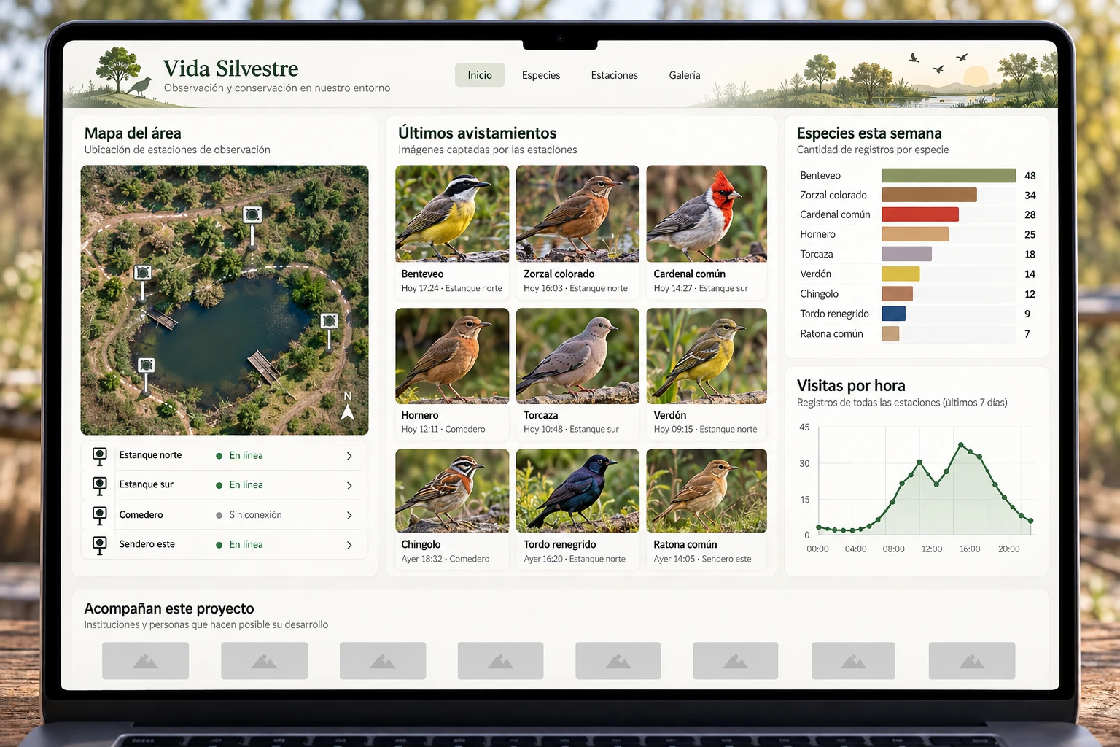
imagenes/renders/_08-web-revisar-dice-vida-silvestre.png
