nik0793/estacion-nativa/imagenes/renders/extra-estanque-ceibo.png

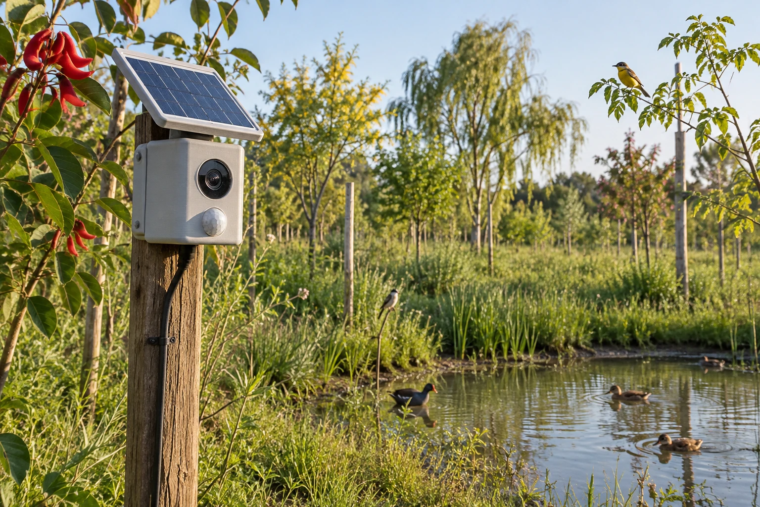
imagenes/renders/extra-estanque-ceibo.png
