nik0793/estacion-nativa/imagenes/renders/web-captura.jpg

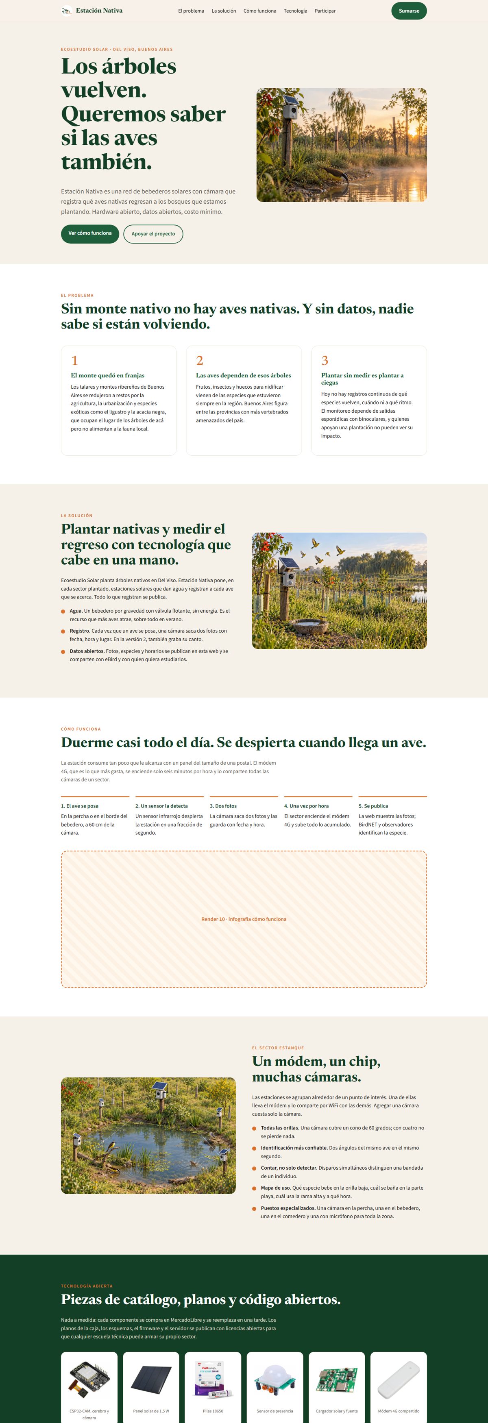
imagenes/renders/web-captura.jpg
