nik0793/estacion-nativa/web/og.png

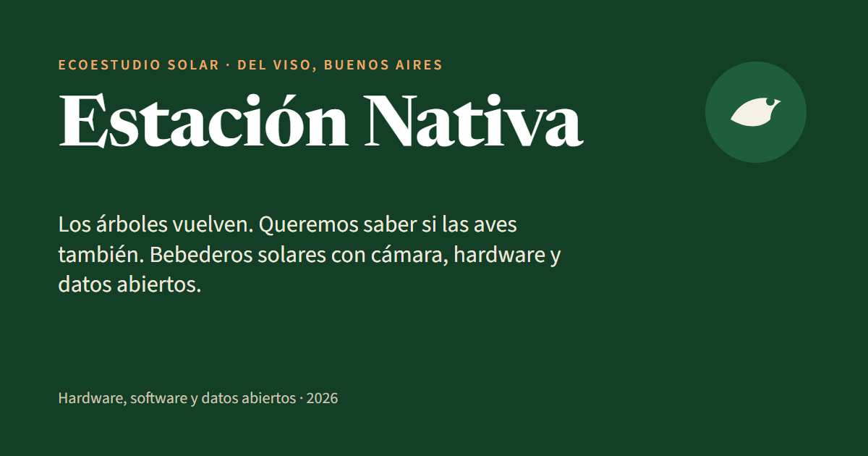
web/og.png
