nik0793/estacion-nativa/(commit log)

2026-10-11 Estación Nativa: documentación, web, servidor y firmware iniciales
    Informe técnico para el taller, presentación problema→solución, web pública,
    servidor PHP+SQLite (API, registros, app, contacto), firmware ESP32-CAM
    (compila, sin probar en hardware), prompts para los renders y fotos de
    componentes con precios verificados el 11/10/2026.
    [estacion.ino]
2026-10-11 Publicación: sitio en Hostinger, renders, JPEG automáticos y formulario
    - Web y servidor publicados en skyblue-gorilla-834934.hostingersite.com; textos y firmware apuntan ahí.
    - Renders de Nicolás (01, 02, 03, 04, 05, 09, 14 y extra); 08 apartado hasta rehacerlo.
    - construir.ps1 y el workflow convierten PNG a JPEG; los PDF usan miniaturas (presentación 2,7 MB, informe 0,7 MB).
    - Formulario de contacto con comprobación GET/HEAD; favicon e ícono desde el isotipo.
    - Prompts con estado y correcciones pedidas.
